robintomar1/fix_my_frother/images/IMG_7897.jpg

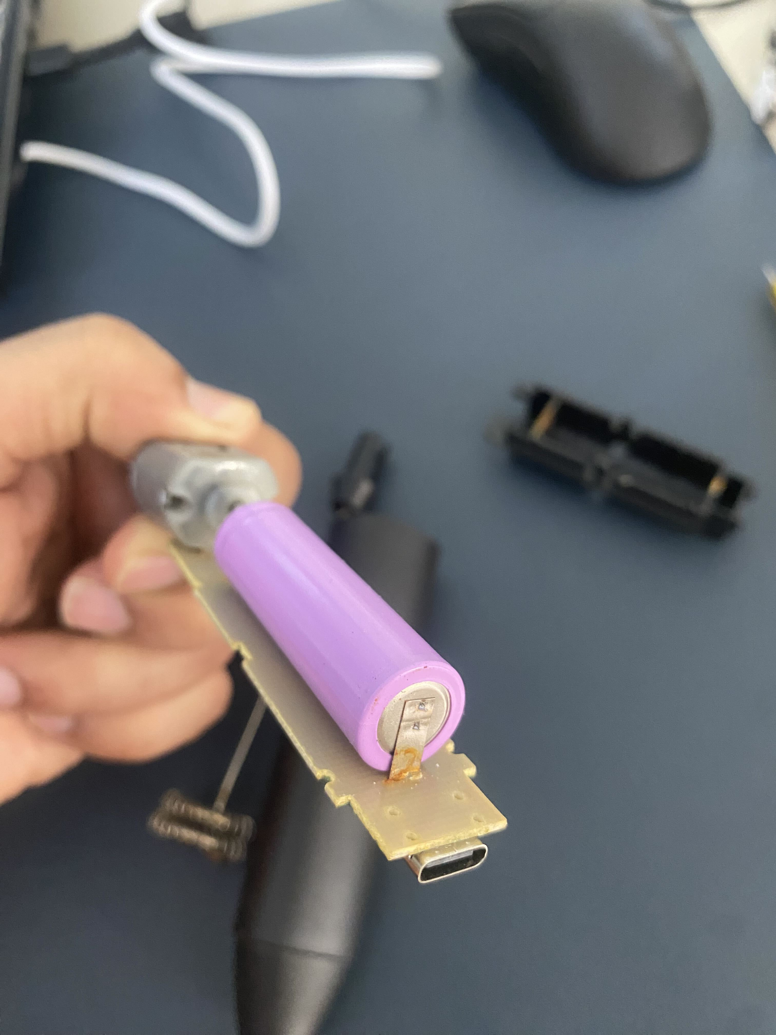
images/IMG_7897.jpg
