robintomar1/fix_my_frother/images/IMG_7893.jpg

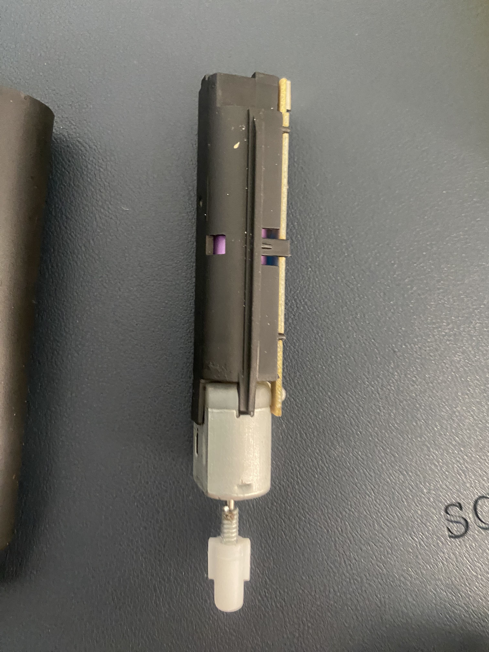
images/IMG_7893.jpg
