robintomar1/fix_my_frother/hardware/board-study/README.md

# Board study

Tracing, identifying, and redrawing the Board (`KD-F316-V1.0`) as a KiCad schematic, to understand how it works. Separate from the repair: see the spec in [#1](https://github.com/robintomar1/fix_my_frother/issues/1) and terms in [`CONTEXT.md`](../../CONTEXT.md).

## Sections

| Section | Issue | Document | Status |
|---|---|---|---|
| Power and charging | [#9](https://github.com/robintomar1/fix_my_frother/issues/9) | [power-section.md](power-section.md) | Drafted from photos; **unverified**, waiting on the meter |
| Motor drive | [#10](https://github.com/robintomar1/fix_my_frother/issues/10) | [motor-section.md](motor-section.md) | Drafted from photos; **unverified**, waiting on the meter |
| Button and LEDs | [#11](https://github.com/robintomar1/fix_my_frother/issues/11) | [button-led-section.md](button-led-section.md) | Parts placed from photos; almost no connections traced yet |
| U1 identity and how the Board works | [#12](https://github.com/robintomar1/fix_my_frother/issues/12) | — | Not started |

## Files

- `frother-board.kicad_pro` / `frother-board.kicad_sch`: the KiCad 9 project and schematic. Open the `.kicad_pro` in KiCad.
- `frother.kicad_sym` + `sym-lib-table`: project symbols for parts with no standard symbol (the 6-pin USB-C receptacle and the unmarked SOP-8 U1).
- `<section>.md`: one per section. Each has a **Connections** table (one row per pad, with evidence, confidence, and a Verified box), a meter checklist, and hypotheses about how the section works.
- `check_netlist.py`: checks the schematic against the Connections tables.

## The check

```
python3 hardware/board-study/check_netlist.py [section.md ...]
```

Exports the schematic's netlist with `kicad-cli` (KiCad 9) and compares every pad's net with the Connections tables; defaults to every `*-section.md` here. A table net of `—` means "not traced yet", and the schematic must leave that pad open. Prints `OK` or lists each disagreement. Run it after every schematic edit and every table update.

It proves **the drawing matches the table**. Only continuity checks with the meter prove **the table matches the Board**.

## Workflow per section

1. Trace from photos into the section's Connections table, with evidence and confidence for each pad.
2. Draw it in KiCad, using net labels that match the table; run the check until it says `OK`.
3. With the meter, work through the section's checklist with power fully off (USB unplugged and the Cell disconnected). Post readings as comments on the section's issue, tick Verified, and replace any `?` placeholder net with the real connection, in both the table and the schematic.
4. Re-run the check. The section is done when every row is verified and the check passes.

## Known ERC results

KiCad's electrical rules check is expected to report:

- **25 unconnected pins**: U1 pins 3–7, LED1–4, R1–R5 and C4. Deliberate: their connections aren't traced yet, and marking them "no connect" would hide that. (U1 pin 1 carries an inferred link to C2; pins 2 and 8 are measured as BAT+ and GND.)
- **4 dangling labels**: `R7_TO_U1?`, `R6_A?`, `R6_B?` and `KEY?`. Each is a single-ended connection whose other end, almost certainly a U1 pin, is unknown.
- **"Library 'Device' not in configuration"**: only when run headless before KiCad has been opened once; the GUI's global library table resolves it.
