robintomar1/fix_my_frother/images/1791776091833.jpg

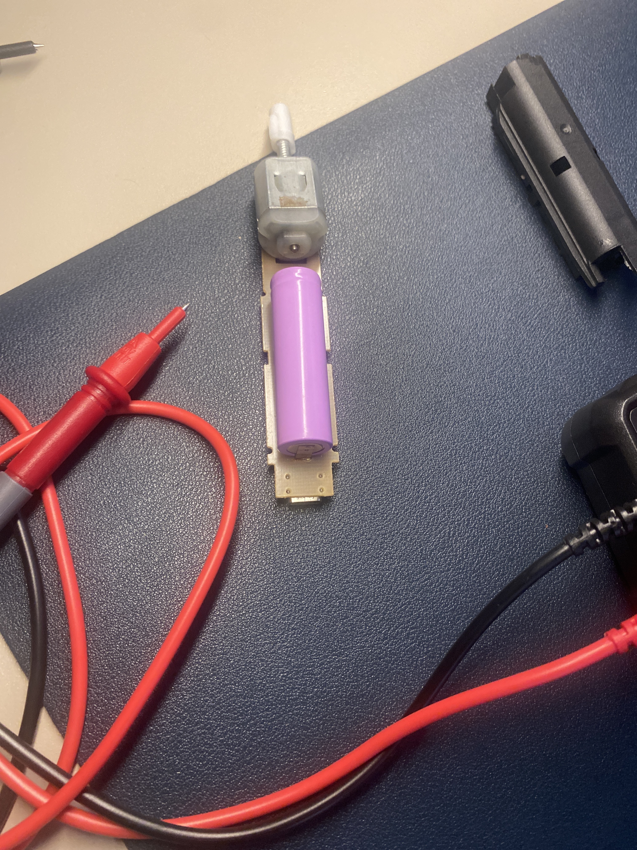
images/1791776091833.jpg
