robintomar1/fix_my_frother/images/1791776119984.jpg

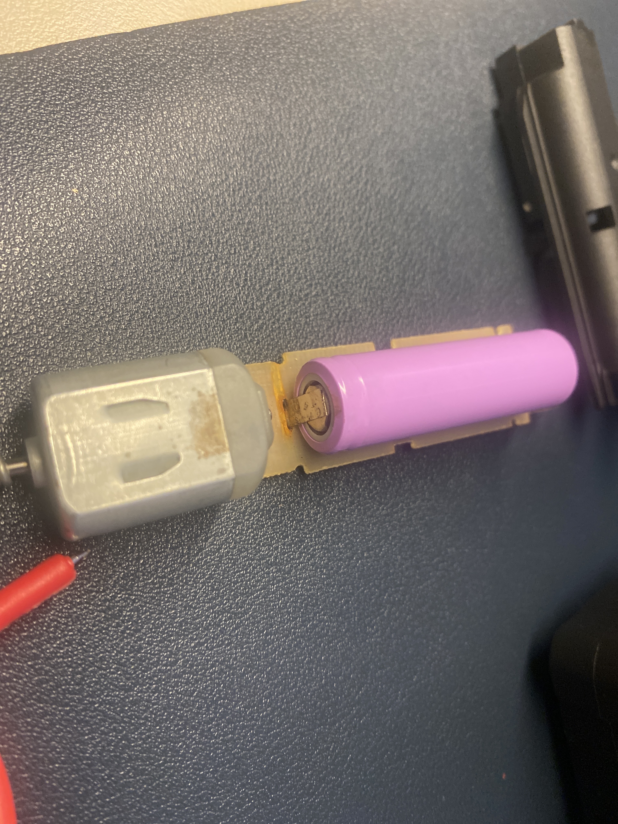
images/1791776119984.jpg
