robintomar1/fix_my_frother/images/IMG_7890.jpg

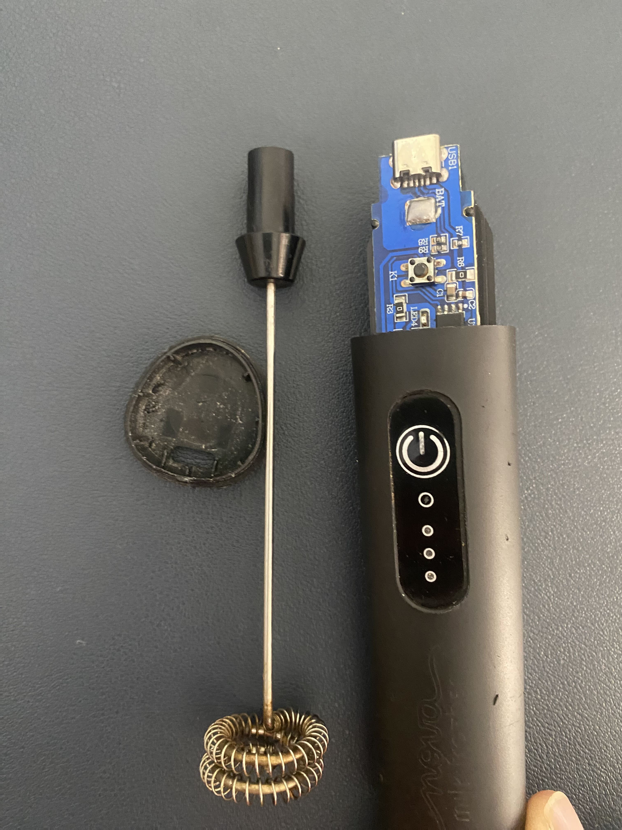
images/IMG_7890.jpg
