robintomar1/fix_my_frother/images/IMG_7891.jpg

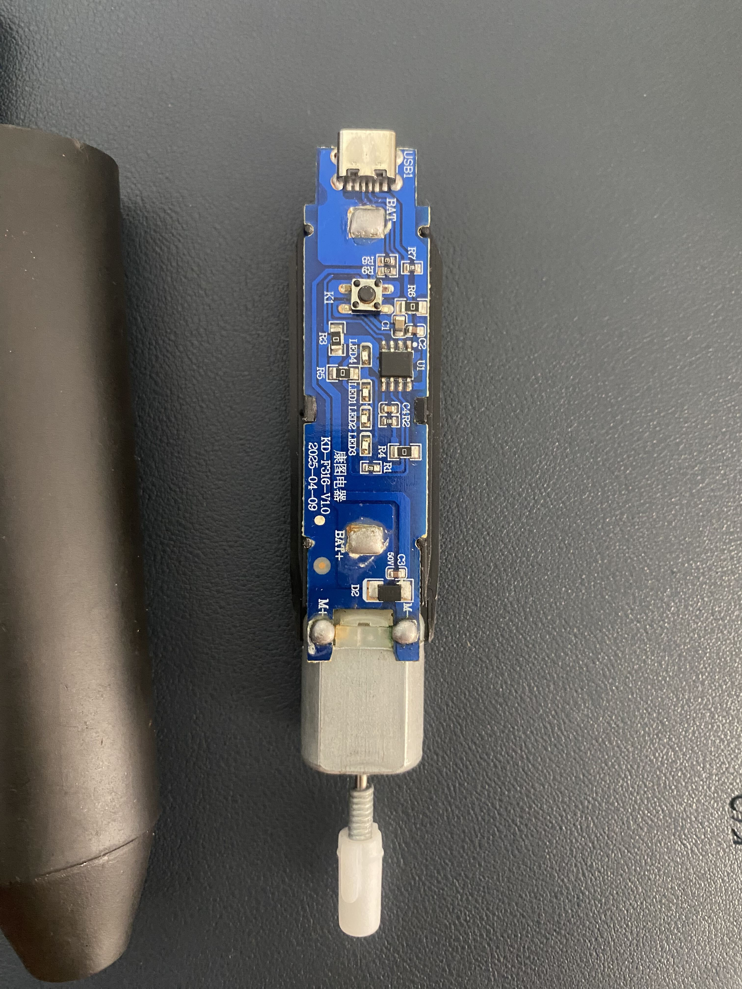
images/IMG_7891.jpg
