robintomar1/fix_my_frother/images/IMG_7892.jpg

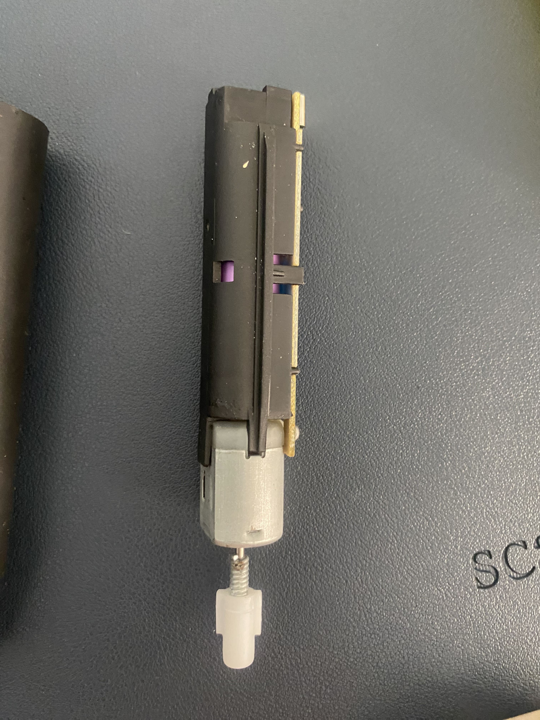
images/IMG_7892.jpg
