robintomar1/fix_my_frother/images/IMG_7894.jpg

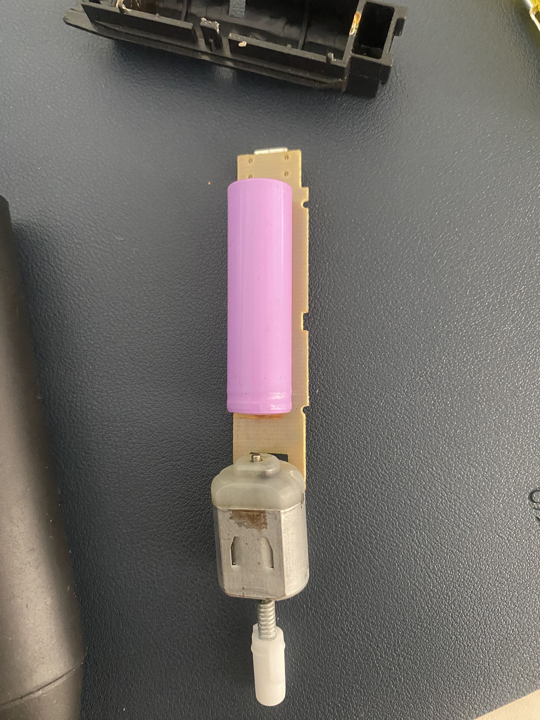
images/IMG_7894.jpg
