robintomar1/fix_my_frother/images/IMG_7895.jpg

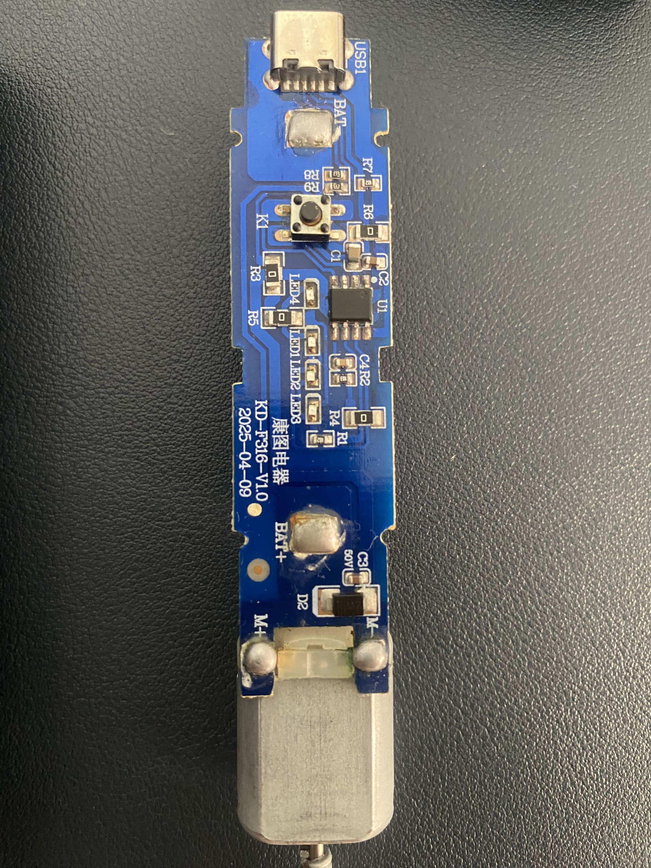
images/IMG_7895.jpg
