robintomar1/fix_my_frother/images/IMG_7896.jpg

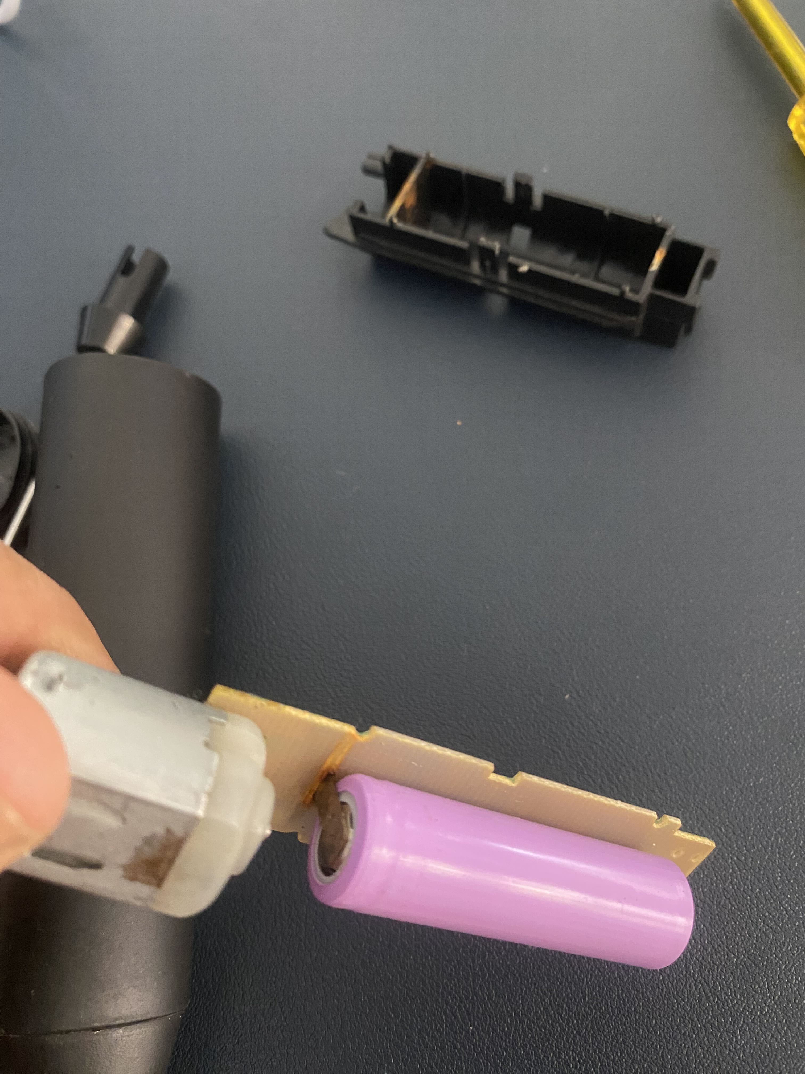
images/IMG_7896.jpg
