robintomar1/fix_my_frother/images/IMG_7898.jpg

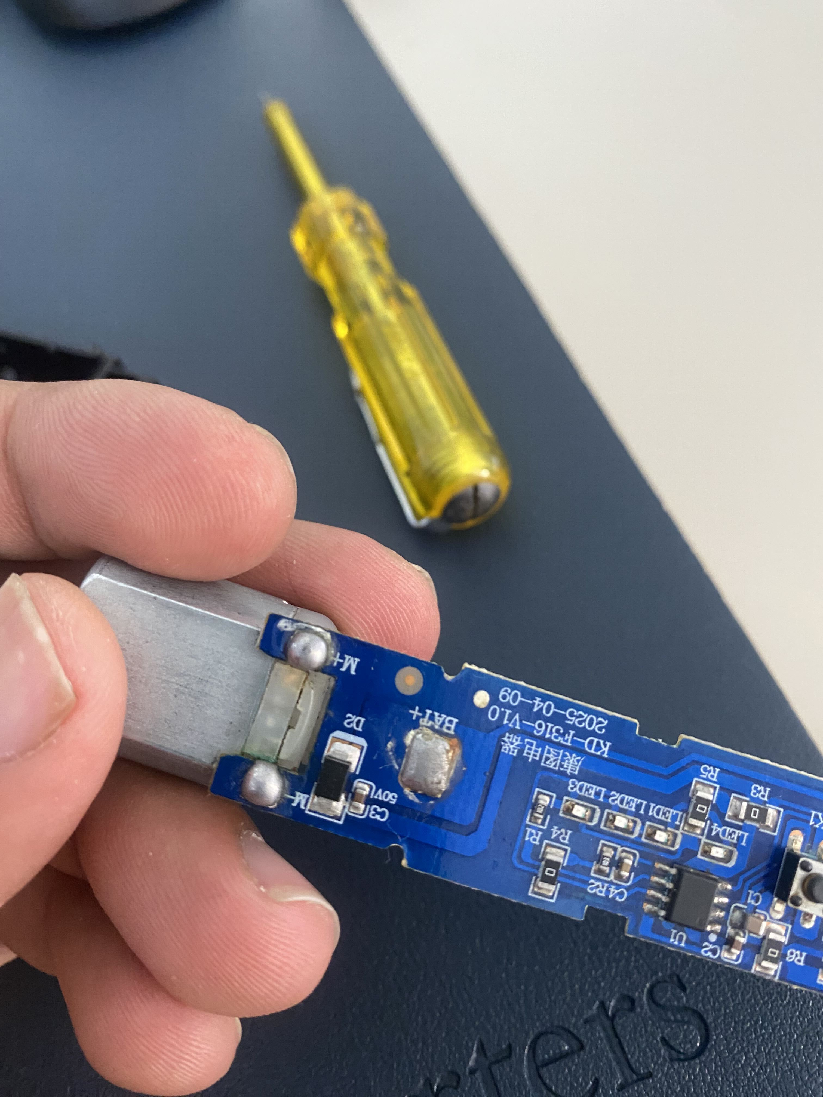
images/IMG_7898.jpg
