robintomar1/fix_my_frother/images/IMG_7899.jpg

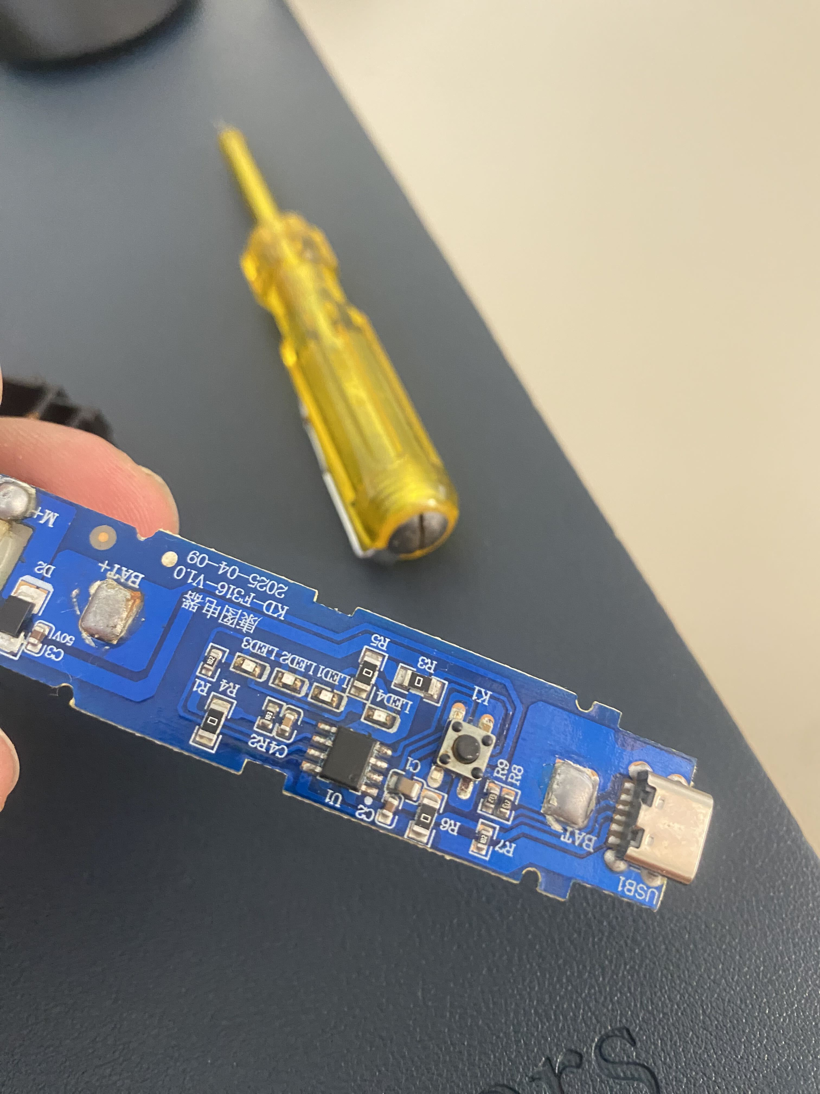
images/IMG_7899.jpg
