robintomar1/fix_my_frother/images/IMG_7909.jpg

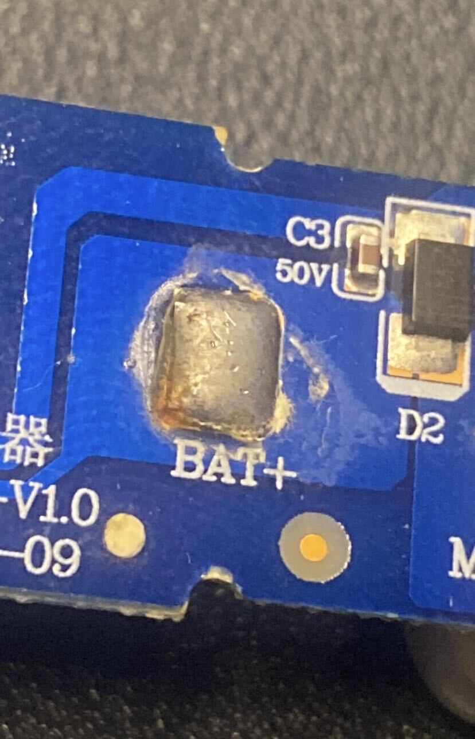
images/IMG_7909.jpg
