robintomar1/fix_my_frother/images/IMG_7911.jpg

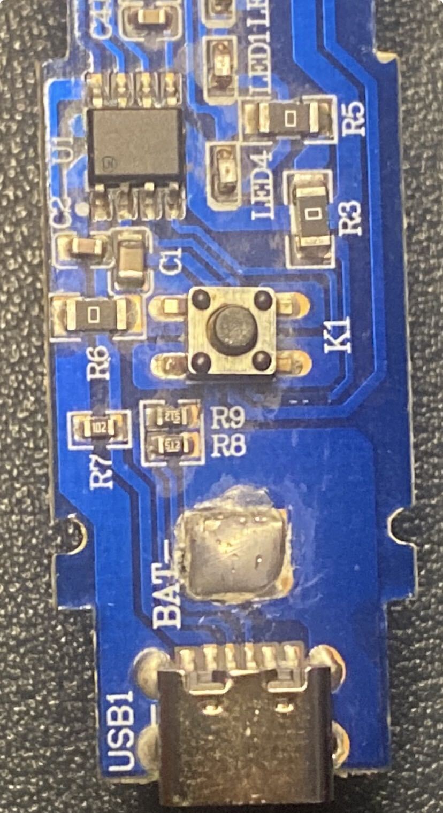
images/IMG_7911.jpg
