robintomar1/fix_my_frother/images/IMG_7912.jpg

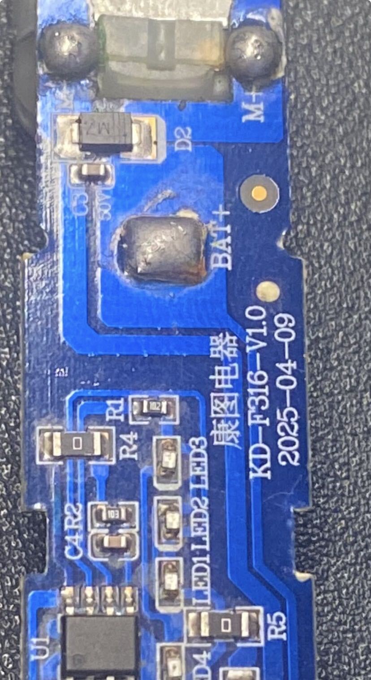
images/IMG_7912.jpg
