robintomar1/fix_my_frother/images/IMG_7913.jpg

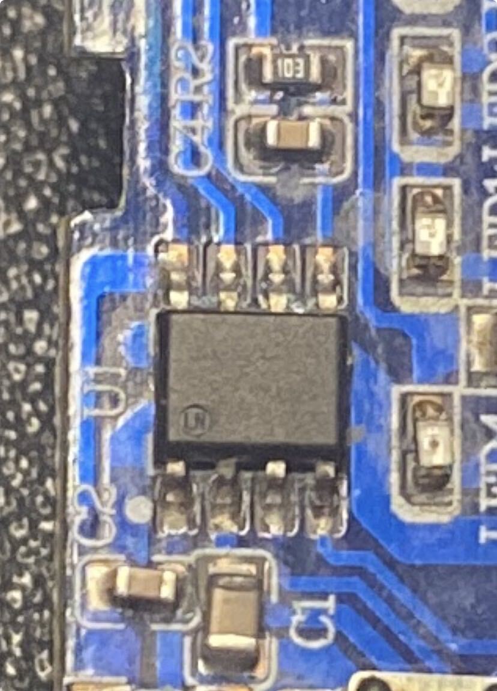
images/IMG_7913.jpg
