robintomar1/fix_my_frother/hardware/board-study/frother-board.kicad_sch

## KiCad design hardware/board-study/frother-board.kicad_sch (2026-10-12)

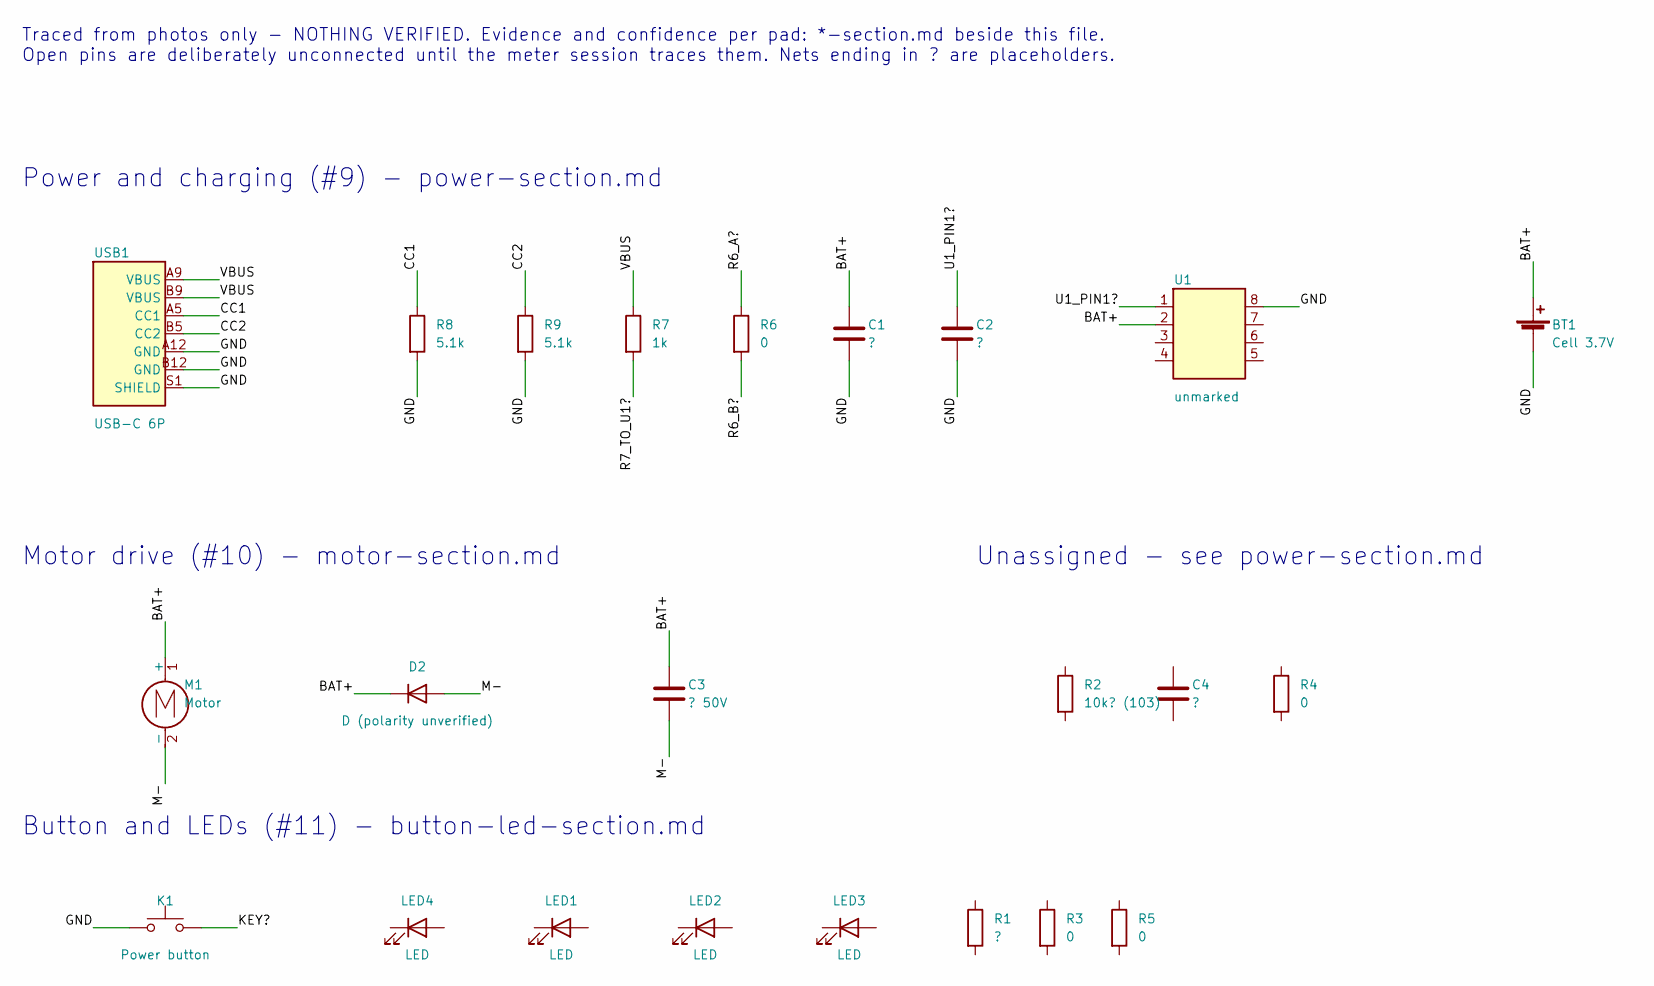
[picture p17: schematic frother-board.kicad_sch]

Parts:
BT1: Cell 3.7V
C1, C2, C4: ?
C3: ? 50V
D2: D (polarity unverified)
K1: Power button
LED1, LED2, LED3, LED4: LED
M1: Motor
R1: ?
R2: 10k? (103)
R3, R4, R5, R6: 0
R7: 1k
R8, R9: 5.1k
U1: unmarked
USB1: USB-C 6P

Connections:
BAT+: BT1.1 (+), C1.1, C3.1, D2.1 (K), M1.1 (+), U1.2
CC1: R8.1, USB1.A5 (CC1)
CC2: R9.1, USB1.B5 (CC2)
GND: BT1.2 (-), C1.2, C2.2, K1.1, R8.2, R9.2, U1.8, USB1.A12 (GND), USB1.B12 (GND), USB1.S1 (SHIELD)
KEY?: K1.2
M-: C3.2, D2.2 (A), M1.2 (-)
R6_A?: R6.1
R6_B?: R6.2
R7_TO_U1?: R7.2
U1_PIN1?: C2.1, U1.1
VBUS: R7.1, USB1.A9 (VBUS), USB1.B9 (VBUS)

Notes on the sheet:
Traced from photos only - NOTHING VERIFIED. Evidence and confidence per pad: *-section.md beside this file. Open pins are deliberately unconnected until the meter session traces them. Nets ending in ? are placeholders.
Power and charging (#9) - power-section.md
Motor drive (#10) - motor-section.md
Unassigned - see power-section.md
Button and LEDs (#11) - button-led-section.md
