robintomar1/fix_my_frother/(commit log)

2026-10-11 Initial commit: agent-skills setup, glossary, and teardown photos
    - AGENTS.md + docs/agents/: issue tracker (GitHub), triage labels, domain doc layout
    - CONTEXT.md: glossary for the Frother repair and Board study
    - images/: teardown photos of the dead Frother showing Tab corrosion
2026-10-11 docs: repair log review fixes
    Glossary wording (disassembly, not teardown; no 'terminals'), accurate
    timeline, Tabs welded to Cell and soldered to Board, Motor casing rust,
    '5 consecutive Sessions', care note trimmed to what was agreed.
    Refs #2
2026-10-11 Board study: KiCad project and draft power/charging section
    Traced from photos only; nothing verified yet (meter not arrived).
    - power-section.md: parts, per-pad Connections table with evidence and
    confidence, U1 pin-1 call, meter checklist, charging hypotheses
    - frother-board.kicad_sch (KiCad 9): power path drawn with net labels;
    U1 pins left unconnected until identified
    - check_netlist.py: exports the netlist via kicad-cli and diffs it
    against the Connections table
    Refs #9
    [frother-board.kicad_sch]
2026-10-11 Board study: review fixes for the power section
    - Confidence now covers the net name, not just the trace: CC and R7
    rows downgraded to inferred; cite both photos
    - C1/C2 tied to U1 pins 2/1 as inferred (pads adjacent, trace unseen)
    - R7 (1 kOhm) can't be the charging path; hypotheses reworded as
    predictions, glossary wording (no "controller"/"shell tabs")
    - List R1-R5 and C4 as parts not yet assigned to a section
    - Meter checklist starts by confirming the U1 pin-1 call
    - check_netlist.py: clear error when a section has no Connections table
    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
    [frother-board.kicad_sch]
2026-10-11 Board study: draft Motor drive and button/LED sections
    Every part on the front of the Board is now in the schematic.
    Traced from photos only; nothing verified yet.
    - motor-section.md: Motor, D2, C3; low-side switching, flyback and
    noise-suppression hypotheses; meter checklist incl. D2 polarity
    - button-led-section.md: K1, LED1-4, R1, R3, R5; panel-window-to-LED
    mapping from position; LED nets untraced; charlieplexing hypothesis
    - R2, C4, R4 drawn as unassigned
    - check_netlist.py: checks every *-section.md; "—" means untraced
    Refs #10, #11
    [frother-board.kicad_sch]
2026-10-11 Board study: record observed button and LED behaviour
    Button: single press on/off, quick presses change speed mode. Dots show
    speed mode when running, charge level when charging. All LEDs blue.
    Hypotheses updated: U1 is most likely a small programmed microcontroller.
    Refs #11, #12
2026-10-11 Board study: LED mapping and speed modes from observed behaviour
    Power symbol never lights; first circle = power on (LED4 by position);
    three speed modes, one dot each, mode 1 default, mode 3 fastest.
    Refs #11
2026-10-11 Glossary: add Speed mode; use it everywhere
    Replaces "speed setting" in the repair log and Board study docs.
    Issues #1, #8, #10, #12 reworded to match.
2026-10-11 Board study: U1 candidate research; fix meter-session power isolation
    - u1-candidates.md: background research on all-in-one SOP-8 chips
    (charger + MCU + Motor switch). Ranked WD8001, CX3320, CX3358B/3318B;
    sources labelled by quality; distinguishing meter checks
    - Checklists said "Board unpowered" but the soldered Cell powers it:
    now require USB unplugged and the BAT+ Tab lifted (natural during #7)
    - Motor coil resistance: red probe on M+, black on M- so D2 doesn't
    skew the reading
    Refs #12
2026-10-11 Board study: turn U1 memory questions into post-repair observations
    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
2026-10-11 Board study: back of the Board is bare apart from the Cell
    Owner's inspection: no parts or copper on the back. U1 must switch the
    Motor itself; removes 'look on the back' branches from checklists.
    Notes the Alibaba 'C1864' board as a contrasting multi-chip design.
    Refs #3, #10, #12
2026-10-11 Board study: attribute 'no copper' to the photo, not the owner
    Refs #3
2026-10-12 Repair log: the Cell reads 0.0 V and is a 14500
    Refs #3, #5
2026-10-12 Board study: R8 measured 5.07 kOhm, confirming its 512 marking
    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
2026-10-12 Photos of the Board's back and front close-ups; record new markings
    - Back of the Board bare apart from the Cell; rust where the Tab bends
    - BAT- label now visible; R2 clearly 103 (10 kOhm)
    - D2 reads M2 (1 A rectifier code); cathode stripe toward M+/BAT+
    - U1 carries a circled "LN" logo at the pin-1 corner, no part number
    Closes #3
    Refs #9, #10, #12
2026-10-12 Repair log: Cell off the Board reads 165 mV
    Refs #5, #6
2026-10-12 Repair log: 3.6 ohm short across BAT+/BAT-
    Refs #5
2026-10-12 Repair log: separate BAT short, suspect Motor, ran on its own
    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
2026-10-12 U1 pin readings: pin 2 = BAT, pin 8 = GND; 3.6 ohm short between them
    - power-section: U1.2 BAT+ and U1.8 GND measured and verified;
    C1.1 now inferred BAT+; schematic regenerated (draft-3)
    - u1-candidates: measured pin table; CX3320, CX3358B, CX3318B ruled
    out; WD8001 still consistent
    - repair log follows in #5 comment
    Refs #5, #9, #12
    [frother-board.kicad_sch]
2026-10-12 Repair log: short located between U1 pin 2 and pin 8
    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
2026-10-12 U1 pin 7: 73.5 kOhm to BAT- (unit confirmed)
    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
2026-10-12 C1 measured across BAT+/GND; Board cleaned twice with IPA
    Refs #4, #5, #9
2026-10-12 Repair log: U1 heats immediately on USB; likely failed
    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
2026-10-12 Repair log: short survives cleaning (3.0 ohm); C1 lift next
    Refs #4, #5
